pellepelster/adsb-flipdot/pcb/README.md

# Flip-dot adapter board

A Raspberry Pi HAT that connects the Pi to the 26-pin header of a Mobitec
flip-dot panel. The board is generated by `build_board.py`.

The signals, the panel pinout, the addresses and how to switch a dot are
described in [docs/mobitec/README.md](../docs/mobitec/README.md).
