pellepelster/adsb-flipdot/docs/mobitec/panel-chips.jpg

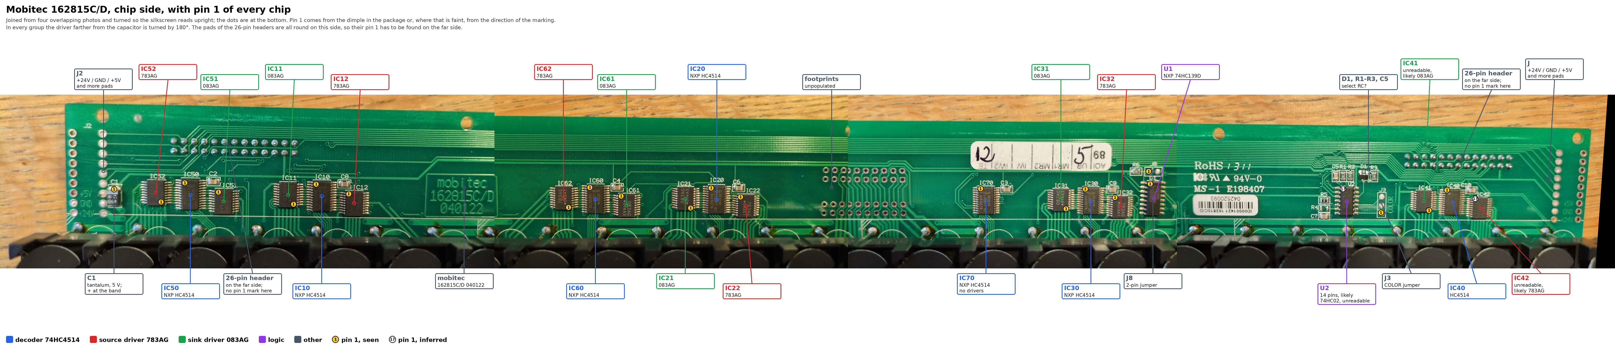
docs/mobitec/panel-chips.jpg
