pellepelster/adsb-flipdot/pcb/bottom.png

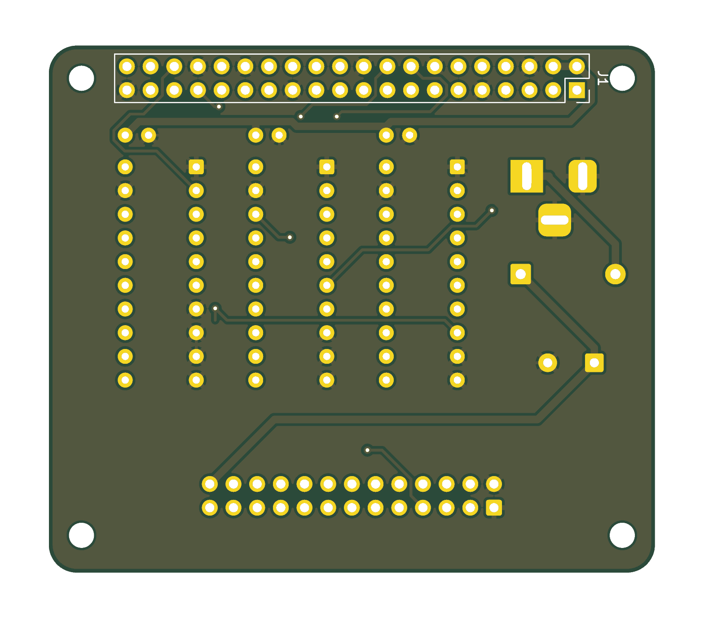
pcb/bottom.png
