pellepelster/adsb-flipdot/pcb/top.png

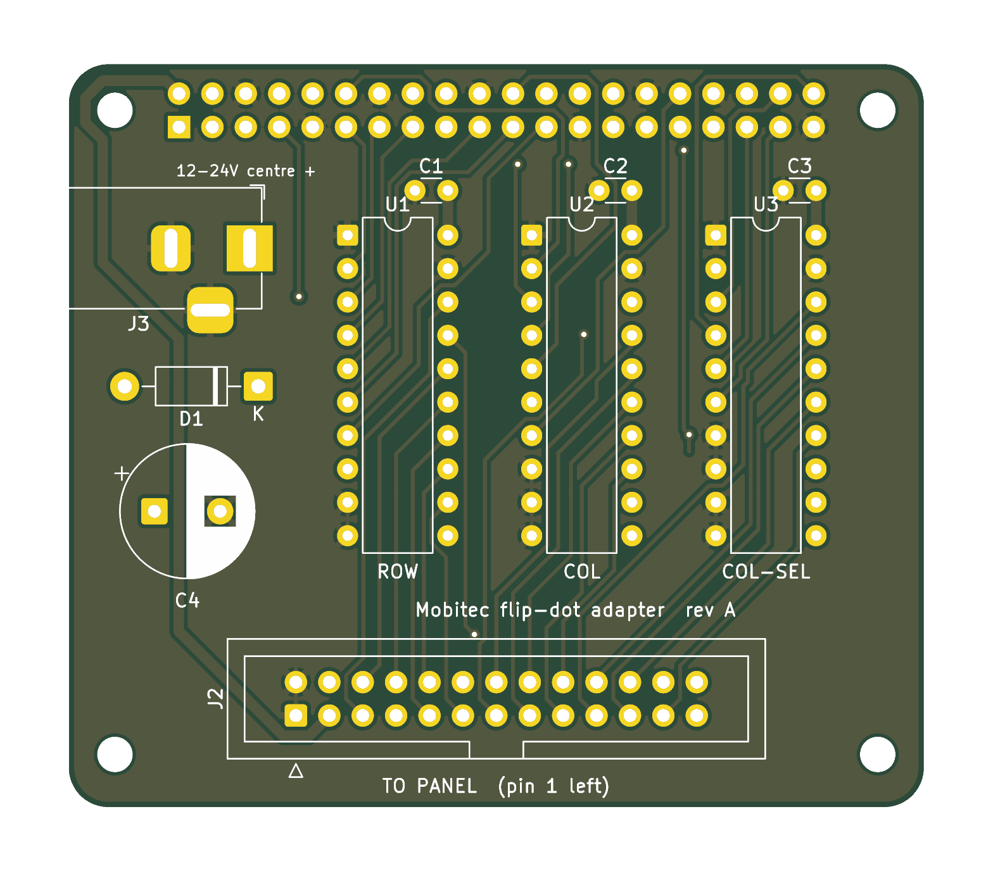
pcb/top.png
