pellepelster/adsb-flipdot/pcb/wiring.png

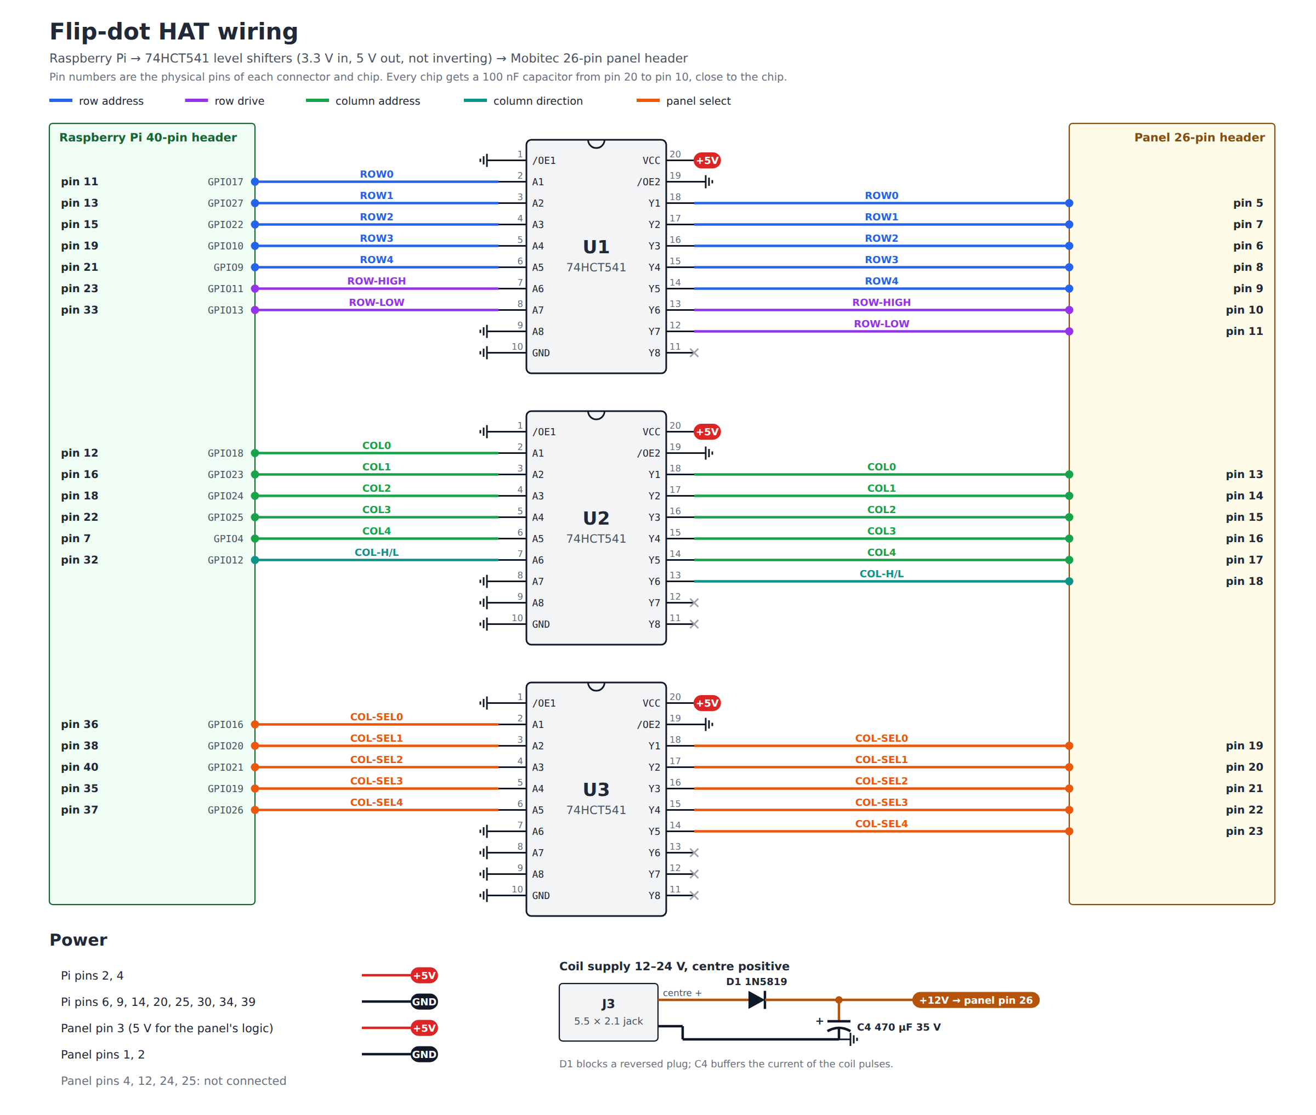
pcb/wiring.png
