pellepelster/adsb-flipdot/pcb/flipdot-hat.kicad_pcb

## KiCad design pcb/flipdot-hat.kicad_pcb (2026-10-12)

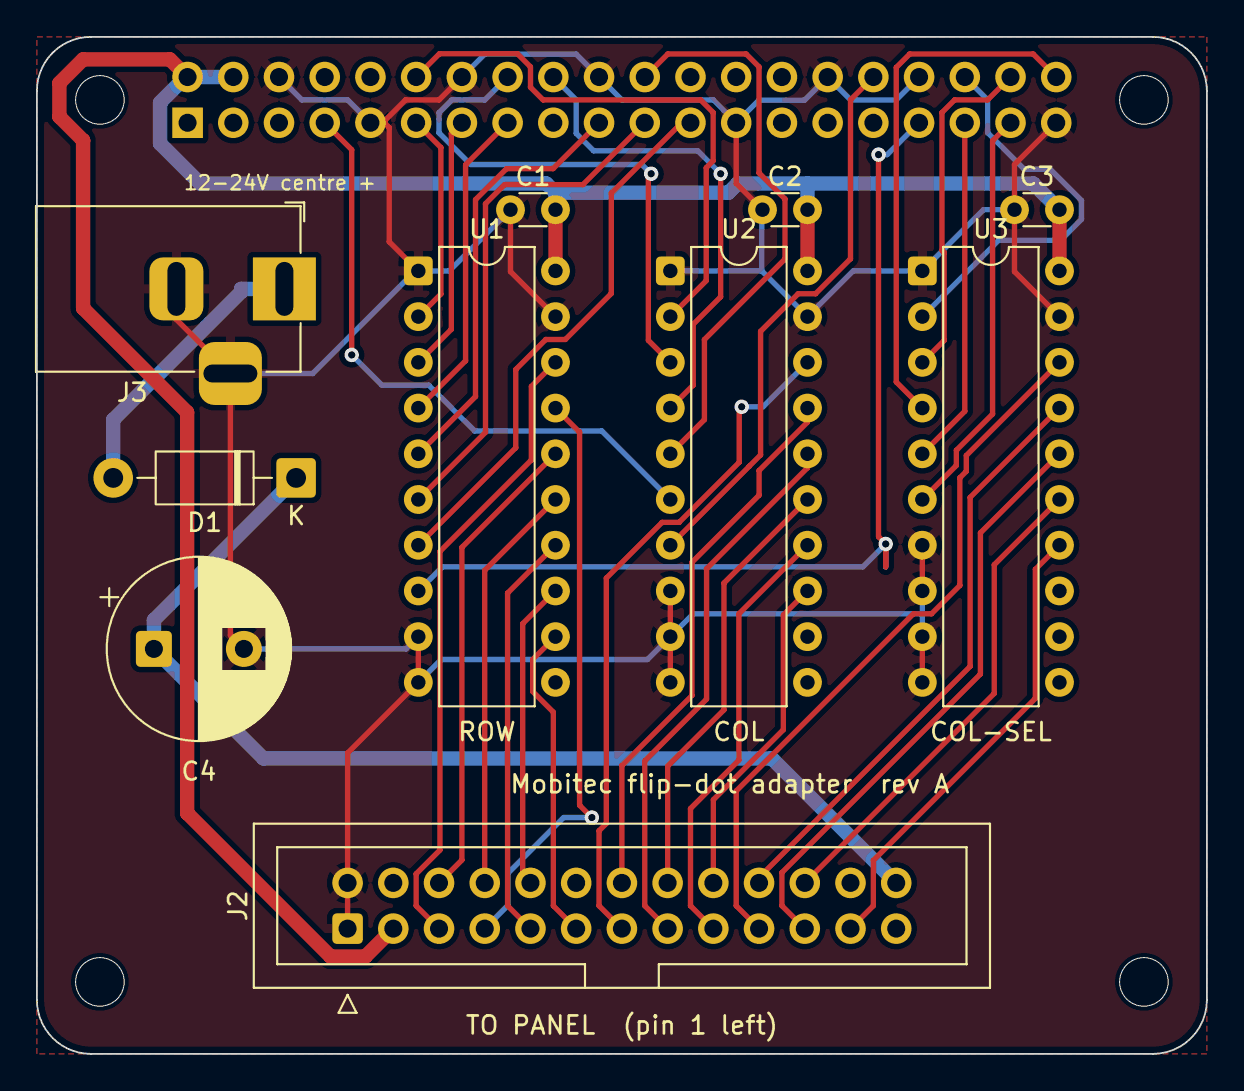
[picture p14: board flipdot-hat.kicad_pcb from above]

Board: 2 copper layers, 65.0 x 56.5 mm, 15 parts (1 on the bottom side), 40 nets.

Parts:
C1, C2, C3: 100n; C_Disc_D3.0mm_W1.6mm_P2.50mm
C4: 470u 35V; CP_Radial_D10.0mm_P5.00mm
D1: 1N5819; D_DO-41_SOD81_P10.16mm_Horizontal
H1, H2, H3, H4: M2.5; MountingHole_2.7mm_M2.5
J1: Pi socket 2x20; PinSocket_2x20_P2.54mm_Vertical
J2: Panel 2x13 IDC; IDC-Header_2x13_P2.54mm_Vertical
J3: 12-24V 5.5x2.1 centre +; BarrelJack_Horizontal
U1, U2, U3: 74HCT541; DIP-20_W7.62mm

Connections:
+5V: C1.1, C2.1, C3.1, J1.2, J1.4, J2.3, U1.20, U2.20, U3.20
+12V: C4.1, D1.1, J2.26
COL0: J2.13, U2.18
COL1: J2.14, U2.17
COL2: J2.15, U2.16
COL3: J2.16, U2.15
COL4: J2.17, U2.14
COL-H/L: J2.18, U2.13
COL-SEL0: J2.19, U3.18
COL-SEL1: J2.20, U3.17
COL-SEL2: J2.21, U3.16
COL-SEL3: J2.22, U3.15
COL-SEL4: J2.23, U3.14
GND: C1.2, C2.2, C3.2, C4.2, J1.6, J1.9, J1.14, J1.20, J1.25, J1.30, J1.34, J1.39, J2.1, J2.2, J3.2, J3.3, U1.1, U1.9, U1.10, U1.19, U2.1, U2.8, U2.9, U2.10, U2.19, U3.1, U3.7, U3.8, U3.9, U3.10, U3.19
PI_COL0: J1.12, U2.2
PI_COL1: J1.16, U2.3
PI_COL2: J1.18, U2.4
PI_COL3: J1.22, U2.5
PI_COL4: J1.7, U2.6
PI_COL-H/L: J1.32, U2.7
PI_COL-SEL0: J1.36, U3.2
PI_COL-SEL1: J1.38, U3.3
PI_COL-SEL2: J1.40, U3.4
PI_COL-SEL3: J1.35, U3.5
PI_COL-SEL4: J1.37, U3.6
PI_ROW0: J1.11, U1.2
PI_ROW1: J1.13, U1.3
PI_ROW2: J1.15, U1.4
PI_ROW3: J1.19, U1.5
PI_ROW4: J1.21, U1.6
PI_ROW-HIGH: J1.23, U1.7
PI_ROW-LOW: J1.33, U1.8
ROW0: J2.5, U1.18
ROW1: J2.7, U1.17
ROW2: J2.6, U1.16
ROW3: J2.8, U1.15
ROW4: J2.9, U1.14
ROW-HIGH: J2.10, U1.13
ROW-LOW: J2.11, U1.12
VIN: D1.2, J3.1
