pellepelster/adsb-flipdot/(commit log)

2026-10-12 Add filter, flipdot simulator, run command, templates and recording
    New commands:
    - run: show aircraft passing a point of interest on the simulated
    flipdot display, with configurable text via --template
    - template-codes: list all template placeholders
    - debug filter: table of aircraft inside a radius and below an altitude
    - debug flipdot: render UTF-8 text as dots, with ticker scrolling
    - debug record: save all frames to a JSON lines file
    Shared pieces:
    - source: replay a recording with --device-record-file, optionally
    faster (--device-record-speed) or looping (--device-record-loop)
    - aircraft_db: resolve registration and type from the tar1090 aircraft
    database, downloaded once into a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
    [aircraft_db.rs, dump.rs, filter.rs, flipdot.rs, live.rs, main.rs, record.rs, run.rs]
2026-10-12 Add CI workflow building x86_64 and Raspberry Pi binaries
    Runs the test suite with nextest and builds release binaries for
    x86_64 and aarch64 musl (via cross), with cargo registry and target
    directories cached per job.
2026-10-12 Show a plain message when the RTL-SDR dongle cannot be opened
    Print errors from main instead of returning them, so no backtrace is
    dumped when RUST_BACKTRACE is set. Tell a missing dongle from a wrong
    device index and from a dongle that is present but cannot be opened.
    [main.rs, source.rs]
2026-10-12 Fix CI annotations: pin runner image and update upload-artifact
    Pin the jobs to ubuntu-24.04 instead of the migrating ubuntu-latest
    label, and move to upload-artifact v7, which targets Node.js 24.
2026-10-12 add pcb desgin
    [flipdot-hat-B_Cu.gbl, flipdot-hat-B_Mask.gbs, flipdot-hat-B_Silkscreen.gbo, flipdot-hat-Edge_Cuts.gm1, flipdot-hat-F_Cu.gtl, flipdot-hat-F_Mask.gts, flipdot-hat-F_Silkscreen.gto, flipdot-hat-NPTH.drl]
2026-10-13 Filter by a square turned to the view direction, show one aircraft at a time
    The area of interest is now a square centred on --lat/--lon instead of a
    circle. --radius is replaced by --size, the edge length in kilometres
    (default 10). The new --view-direction (default 153) turns the square so
    that two of its edges run parallel to the direction of view.
    The display stays with one aircraft until it has left the square and only
    then moves on to the one that has been inside the longest.
    [filter.rs, main.rs, run.rs, template.rs]
2026-10-13 Add an illustration of the filter area
    docs/filter-area.svg (and a PNG render) shows the point of interest as a
    house, the filter box around it and the runways of Hamburg Airport in the
    distance. docs/render_filter_area.py draws it from the FilterParams
    defaults and the real runway thresholds.
2026-10-13 Set width, length and offset of the filter rectangle separately
    --size is replaced by --area-width and --area-length, the edges across and
    along the view direction in kilometres (default 10 each). The new
    --area-offset says how much of the length lies ahead of the point, in
    percent: the default 50 centres the rectangle on the point, 100 puts all
    of it ahead and 0 all of it behind.
    The options carry the area- prefix because run already has --width for
    the panel width in dots.
    [filter.rs, main.rs, run.rs, template.rs]
2026-10-13 Default the filter rectangle to 4 km wide and 6 km long
    The illustration is redrawn for the new defaults.
2026-10-13 Drop the not-to-scale note from the filter area illustration
2026-10-13 Describe the adapter board's signals and how to switch a dot
    pcb/README.md lists every signal with its Pi pin, GPIO and panel pin, the
    row and column address codes, and the pin levels and pulse timing that
    switch dot 1/1 on and off.
2026-10-13 Label the airport with its ICAO code in the filter area illustration
2026-10-13 Build for 32-bit Raspberry Pi as well
    The Pi 2 Model B rev 1.1 is 32-bit only and cannot run the aarch64 binary.
    build:pi:32 and the CI job raspberry-pi-32 build for
    armv7-unknown-linux-musleabihf; build:pi:64 is the former build:pi, and
    build:pi now builds both.
    Each task has its own target directory, because the two cross images differ
    in glibc and cannot run each other's build scripts.
2026-10-13 Add debug pi to switch the adapter board's signals by hand
    A table of the 18 signals the board passes on to the panel. Space toggles
    an address or direction line; the COL-SEL lines, which let the coil
    current flow, can only be pulsed for --pulse-us (default 190, at most
    25000) and return low by themselves. Raising ROW-HIGH or ROW-LOW lowers
    the other one first. Every line is driven low when the command ends.
    The pulse is timed with a busy wait on a thread with real-time priority,
    where the system allows it, and its measured length is shown. --dry-run
    touches no pin.
2026-10-13 Pin python and ansible in mise
2026-10-13 Flip only the dots that differ and show them in the terminal
    A Display remembers what the dots show and turns each frame into the
    flips that differ from it. Outputs are attached to it and all get the
    same flips. The terminal preview is such an output: it changes its dots
    only by those flips, marks the ones flipped for a frame and counts them.
    [display.rs, flipdot.rs, main.rs, run.rs]
2026-10-13 Add the panels on the adapter board as a display output
    With --gpio, run and debug flipdot flip the dots of the panels through
    the adapter board, next to the preview in the terminal. Each flip sets
    the addresses and the direction and pulses the COL-SEL line of its
    panel; only the lines that change are written.
    SIGINT, SIGTERM and SIGHUP now end both commands between two frames,
    so that none of them can cut a pulse short and leave a coil energised.
    [flipdot.rs, main.rs, panel.rs, pi.rs, run.rs]
2026-10-13 Split the board driver and the scene out of the debug commands
    pi.rs held the adapter board driver next to the `debug pi` screen, and
    panel.rs had to import the driver from a module named after a debug
    command. The signal table, the pins, `Board` and the real-time setup now
    live in board.rs with their tests; pi.rs is the screen only.
    flipdot.rs held the dot grid and text layout next to the `debug flipdot`
    command, so display.rs and flipdot.rs imported each other. `FrameBuffer`,
    `Scene`, the fonts, alignment and scroll mode now live in scene.rs. The
    rendering of dots as terminal text moves to display.rs, where the terminal
    output is, so scene.rs depends on nothing in the crate.
    Seven tests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
    [board.rs, display.rs, filter.rs, flipdot.rs, main.rs, panel.rs, pi.rs, record.rs]
2026-10-13 Take the default panel width from the board's column limit
    The number 28 was written down twice: as the most columns the board can
    address and as the default width of a panel. The default now refers to
    the limit. The height stays its own number, because the panels have 14
    rows of the 16 the board can address.
    The limits are `u32` like every other dot count, which removes the
    conversions where the panel output compares them with the display size.
2026-10-13 Restore the terminal when a full-screen command is killed
    `debug live` and `debug filter` listened for Ctrl-C only. A plain `kill`
    or a closed terminal window ended them at once, with the terminal still in
    raw mode on the alternate screen and the dongle not stopped.
    `Shutdown` waits for SIGINT, SIGTERM and SIGHUP. Every command uses it in
    place of its own list of signals, so they all end the same way: the loop
    stops, the terminal is restored, the source is closed and the lines of the
    panel go low.
2026-10-13 Give the aircraft tracker its own module and untangle the panel output
    The aircraft filter kept its positions in `live::Table`, a type named
    after the table of `debug live` and after a ratatui widget. It is
    `tracker::Tracker` now, and live.rs only draws it.
    flipdot.rs and panel.rs imported each other: the display arguments opened
    the panels, and the panels read the display arguments. The panel output
    now takes an `Arrangement`, the number, size and layout of the panels,
    which is also the one place that works out the size of the display.
    [filter.rs, flipdot.rs, live.rs, main.rs, panel.rs, record.rs, tracker.rs]
2026-10-13 Fold the code that the commands had in two copies
    `debug pi` and the panel output each declared `--chip` and `--pulse-us`
    and each opened the board and worded its priority. `BoardArgs` holds the
    two options and opens the board for both. The two busy waits in the board
    are one `spin_until`.
    `debug pi` and the table commands each set up the full-screen terminal,
    read its keys and knew which of them quit. `Screen` does that for both,
    and `debug pi` uses the table columns and cells of tui.rs.
    The number parsers of the filter and the source options are
    `parse::number_in` and `parse::positive`. `FrameStream::open` builds the
    stream in one place for the dongle, an IQ file and a recording.
    Co-Aut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
2026-10-13 Sort the modules into layers
    The modules move into one directory per layer, with no change to the code:
    `domain` for the business code, `output` for the terminal preview and the
    panels, `source` for the dongle and the aircraft database, `commands` for
    the loops that wire them together and `cli` for parsing options.
    The layers are not clean yet. The steps that follow take the option
    parsing out of `domain`, `output` and `source`.
2026-10-13 Separate working out the flips from showing them
    display.rs did two jobs: it worked out which dots differ from what is
    shown, and it drew them in the terminal. The first is business code and
    moves to `domain/dots.rs` as `Shown`, next to the dot grid it compares.
    The terminal preview becomes `output/terminal.rs`. `Display` stays in the
    output layer and only hands the flips of a frame to its outputs.
    [flipdot.rs, mod.rs, panel.rs, run.rs, terminal.rs]
2026-10-13 Draw the table of `debug filter` in the command, not in the filter
    `Filter` implemented the table view of the terminal UI itself, so the
    business code knew about ratatui. Feeding frames and dropping silent
    aircraft are plain methods of the filter now, and a flight tells how many
    positions it gave, how close it came and when it was last heard.
    `commands/filter.rs` holds the table and draws it from the flights.
2026-10-13 Keep option parsing in `cli`, away from the other layers
    Fonts, panels, the frame source and the filter all carried clap attributes,
    and core types took option structs as their input. Now `cli` owns every
    option of every command and turns the options into plain values:
    - the frame stream takes a `Source`: a dongle, an IQ file or a recording
    - the panel output takes a `PanelConfig`, the board a `BoardConfig`
    - text is set with a `Typesetting`, as before
    - the names and help texts of fonts, alignment, scrolling and layout are
    given in `cli`, so those types no longer derive from clap
    The aircraft database splits the same way. The table of aircraft and its
    parser are business code in `domain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
    [aircraft_db.rs, board.rs, display.rs, dump.rs, filter.rs, flipdot.rs, live.rs, main.rs]
2026-10-13 Check with a test that the layers keep to themselves
    The test reads the files of each layer and fails if one of them mentions a
    library or a layer it must not know: clap, a terminal or a pin in `domain`,
    option parsing in `output` and `source`, a command in `cli`.
    Each layer says at the top of its module what belongs in it.
    [main.rs, mod.rs]
2026-10-15 Describe the Mobitec panel and how its pinout was verified
    The signals, addresses and switching sequence move from the PCB README
    to docs/mobitec, next to the steps that checked them on a real panel and
    what each step found.
2026-10-16 Explain how the display works, with diagrams
    The README introduces the project and explains the flip-dot panel: how
    the coil flips a disc, how the row and column address pick a dot, and
    how direction, row enable and the select pulse flip it. The panel notes
    link the same diagrams, and pcb/wiring.png shows how the HAT connects
    the Pi to the panel pin by pin.
