pellepelster/adsb-flipdot/docs/mobitec/IMG_20261014_172015_709.jpg

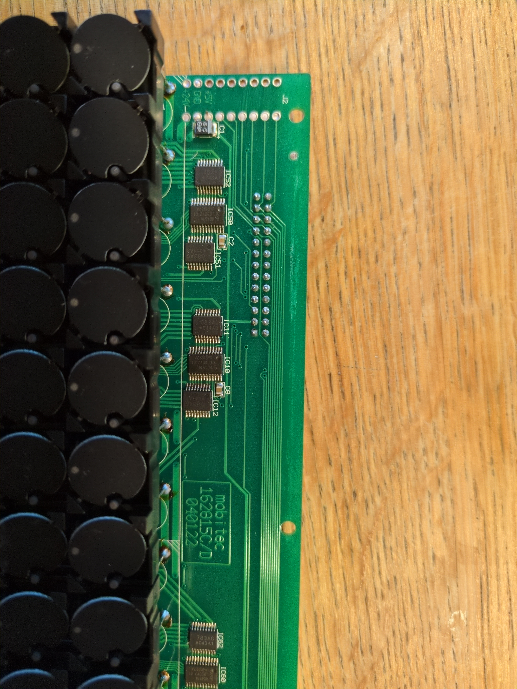
docs/mobitec/IMG_20261014_172015_709.jpg
