pellepelster/adsb-flipdot/docs/mobitec/IMG_20261014_172020_450.jpg

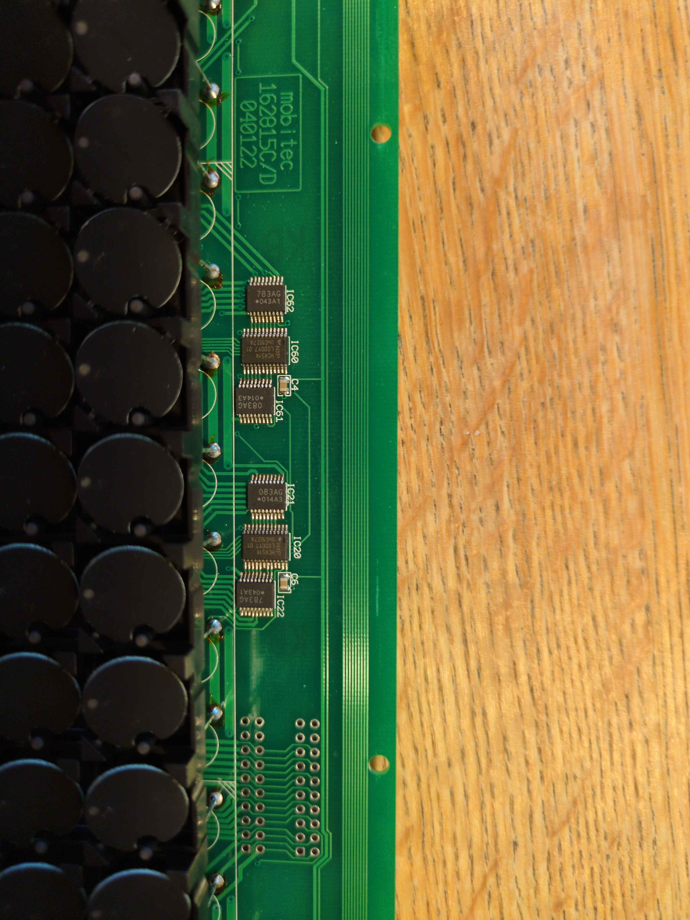
docs/mobitec/IMG_20261014_172020_450.jpg
