pellepelster/adsb-flipdot/docs/mobitec/IMG_20261014_172024_567.jpg

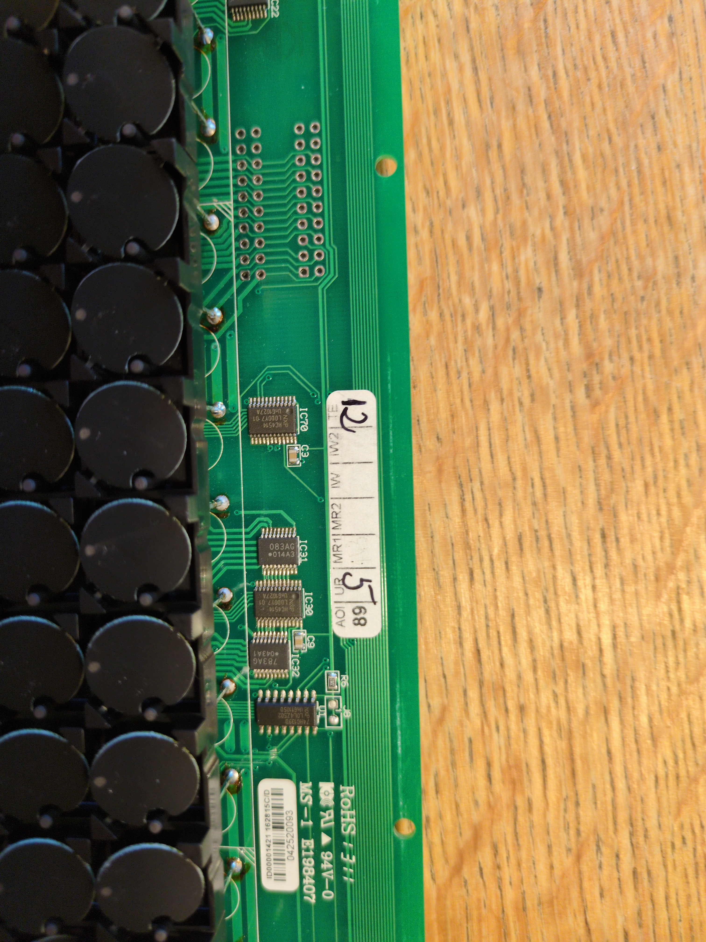
docs/mobitec/IMG_20261014_172024_567.jpg
