pellepelster/adsb-flipdot/docs/mobitec/IMG_20261014_172028_164.jpg

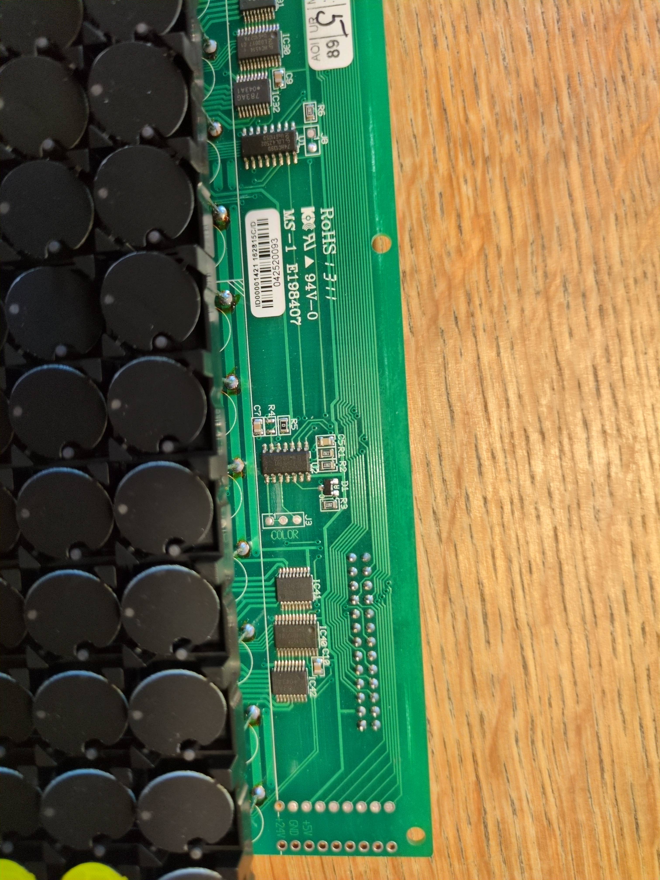
docs/mobitec/IMG_20261014_172028_164.jpg
